M1RK02/SWDPProject/report/figures/Layer Stack.png

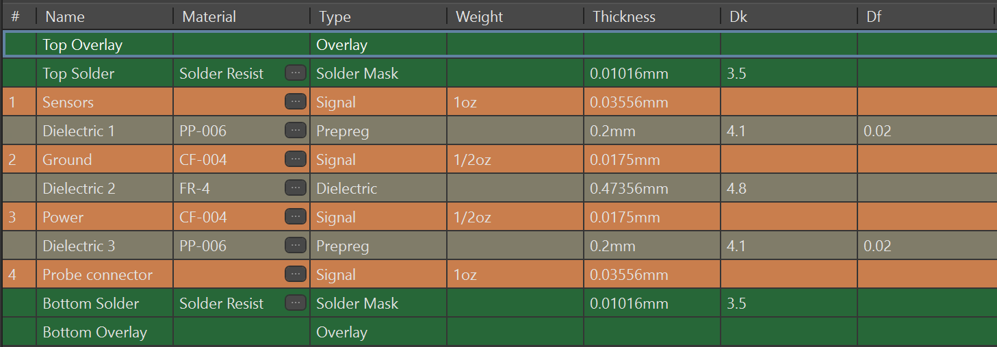
report/figures/Layer Stack.png
