M1RK02/SWDPProject/altium/Project Outputs for Lumos_Probe/BOM/Bill of Materials-Lumos_Probe.xlsx

Line # | Name | Description | Designator | Quantity | Manufacturer 1 | Manufacturer Part Number 1 | Manufacturer Lifecycle 1 | Supplier 1 | Supplier Part Number 1 | Supplier Unit Price 1 | Supplier Subtotal 1
 | 0402YC104JAT4A | Ceramic Capacitor, Multilayer, Ceramic, 16V, 5% +Tol, 5% -Tol, X7R, 15% TC, 0.1uF, Surface Mount, 0402 | C1, C3 | 2 | KYOCERA AVX | 0402YC104JAT4A | Volume Production | Avnet | KGM05AR71C104JN | 0.01101 | 550.5
 | 0402YD105KAT4A | Ceramic Capacitor, Multilayer, Ceramic, 16V, 10% +Tol, 10% -Tol, X5R, 15% TC, 1uF, Surface Mount, 0402 | C2 | 1 | KYOCERA AVX | 0402YD105KAT4A | Volume Production | Avnet | KGM05AR51C105KN | 0.0245 | 1225
 | BM29B0.6-24DS/2-0.35V(51) | Connector Receptacle 26 Pos (24+2) SMD | CONN1 | 1 | HIROSE ELECTRIC | BM29B0.6-24DS/2-0.35V(53) | Volume Production | DigiKey | 26-BM29B0.6-24DS/2-0.35V(53)CT-ND | 1.96 | 1.96
 | CR0201-JW-472GLF | Fixed Resistor, Metal Glaze/thick Film, 0.05W, 4700ohm, 30V, 5% +/-Tol, 200ppm/Cel, Surface Mount, 0201 | R1, R2, R3 | 3 | Bourns | CR0201-JW-472GLF | Volume Production | DigiKey | 118-CR0201-JW-472GLFCT-ND | 0.018 | 0.18
 | IMP34DT05 | MEMS audio sensor omnidirectional digital microphone for industrial applications | U2 | 1 |  |  |  | Farnell | 2980886
 | AS7341-DLGT | Optical Sensor Ambient - IÂ²C 8-TFLGA | U1 | 1 |  |  |  | Farnell | 4328201
