M1RK02/SWDPProject/report/figures/PCB matrix manufacturer .png

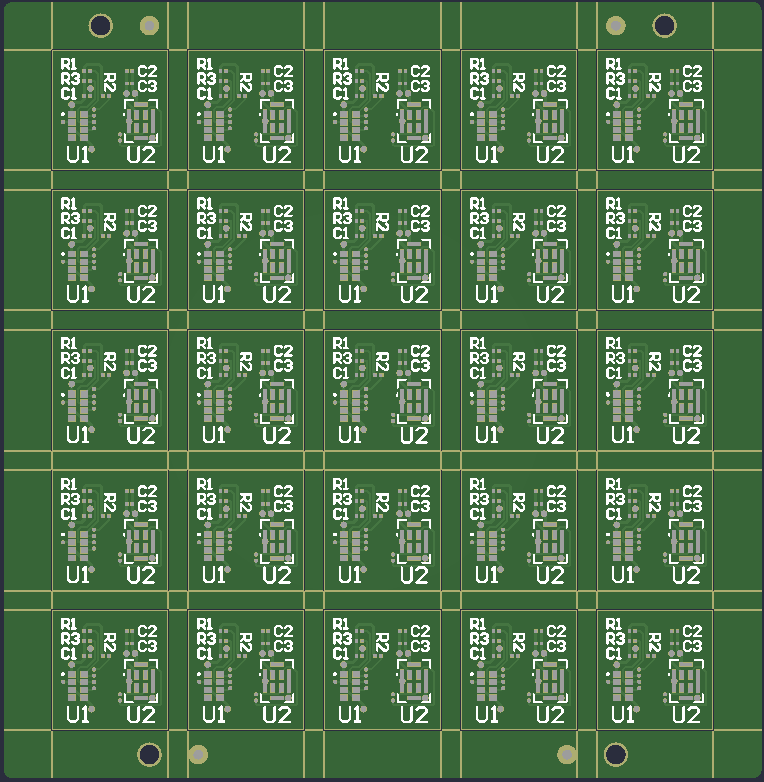
report/figures/PCB matrix manufacturer .png
