M1RK02/SWDPProject/(list of files, drawings)

Other design files:
altium/Lumos_Probe.PcbDoc
altium/Lumos_Probe.PcbLib
altium/Lumos_Probe.PrjPcb
altium/Lumos_Probe.SchDoc
altium/Lumos_Probe.SchLib
