M1RK02/SWDPProject/firmware/inference/Core/Src/main.c

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
/* Includes ------------------------------------------------------------------*/
#include "main.h"

/* USER CODE BEGIN Includes */
#include "string.h"
#include "stdio.h"
#include "../../USB_Device/App/usb_device.h"
#include "SPI.h"
#include "SPI_NAND.h"
#include "Memory_operations.h"
#include "led_driver.h"
#include "imu_driver.h"
#include "bluetooth.h"
#include "as7341.h"
#include "network.h"         // ST Edge-AI generated header
#include "network_data.h"    // Contains weights definitions
#include <math.h>
#include "features.h"
/* USER CODE END Includes */

/* USER CODE BEGIN PD */
// --- ⚙️ ARBITRARY INFERENCE STRIDE CONFIGURATION ---
#define INFERENCE_STRIDE_PACKETS   9  // 1 = Every 381ms, 3 = Every 1.1s, 9 = Non-overlapping
/* USER CODE END PD */


I2C_HandleTypeDef hi2c3;

MDF_HandleTypeDef MdfHandle0;
MDF_FilterConfigTypeDef MdfFilterConfig0;
DMA_NodeTypeDef Node_GPDMA1_Channel0;
DMA_QListTypeDef List_GPDMA1_Channel0;
DMA_HandleTypeDef handle_GPDMA1_Channel0;

SPI_HandleTypeDef hspi2;
SPI_HandleTypeDef hspi3;

UART_HandleTypeDef huart3;

PCD_HandleTypeDef hpcd_USB_OTG_FS;

/* USER CODE BEGIN PV */
// --- AI Framework Handles & Buffers (RESTORED TO FIX COMPILATION ERRORS) ---
static ai_handle network_instance = AI_HANDLE_NULL;

#define ACTIVATION_BUF_SIZE AI_NETWORK_DATA_ACTIVATIONS_SIZE
// 4-byte aligned internal activation buffer required for NN layer execution
static uint8_t activations_buffer[ACTIVATION_BUF_SIZE] __attribute__((aligned(4)));

static ai_buffer ai_input[AI_NETWORK_IN_NUM];
static ai_buffer ai_output[AI_NETWORK_OUT_NUM];

// --- Hardware Streaming Buffers ---
int16_t audio_circular_buffer[AUDIO_CIRC_BUF_SIZE]; // Double DMA Ping-Pong buffer

// --- Raw Sliding Window Storage Arrays ---
static int16_t audio_window_history[WINDOW_PACKET_COUNT][BLOCK_AUDIO_SAMPLES];
static uint16_t spectro_window_history[WINDOW_PACKET_COUNT][SPECTRAL_CHANNELS];
static AS7341_Flicker_t flicker_window_history[WINDOW_PACKET_COUNT]; // Aligned with updated struct type

static int write_ptr = 0;
static int blocks_accumulated = 0;
static int stride_counter = 0;

// Scratchpad buffer to piece together the continuous 3.43-second wave for processing
static int16_t audio_processing_scratchpad[TOTAL_WINDOW_SAMPLES];

// Output predictions buffer explicitly set to int8_t for the quantized output layer
static int8_t nn_output_predictions[AI_NETWORK_OUT_1_SIZE];
// Quantized input features array for X-CUBE-AI model (Size: 41)
static int8_t nn_input_features[AI_NETWORK_IN_1_SIZE];
// Temporary float array for feature extraction and normalization (Size: 41)
static float nn_input_features_float[AI_NETWORK_IN_1_SIZE];

static volatile uint8_t data_processing_requested = 0;
static volatile int processing_write_ptr = 0;

// Spectrometer data structures (Synchronized with data_logger)
AS7341_Handle_t h_as7341;
AS7341_SpectralData_t spectral_data;
AS7341_SpectralData_t spectral_data_buffer;
volatile bool spectral_data_ready = false;

// --- Global Flags and Variables ---
// Flag to indicate a USB connection event.
// Set to 1 when a USB connection is detected.
uint8_t usb_flag = 0;
/* USER CODE END PV */

void SystemClock_Config(void);
static void MX_GPIO_Init(void);
static void MX_GPDMA1_Init(void);
static void MX_ICACHE_Init(void);
static void MX_I2C3_Init(void);
static void MX_USART3_UART_Init(void);
static void MX_USB_OTG_FS_PCD_Init(void);
static void MX_MDF1_Init(void);
static void MX_SPI3_Init(void);
static void MX_SPI2_Init(void);
/* USER CODE BEGIN PFP */
/* USER CODE BEGIN 0 */
/**
  * @brief  Initializes X-CUBE-AI Network instances
  */
void AI_Init(void)
{
    ai_error err;
    ai_handle activations_list[] = { (ai_handle)activations_buffer };

    err = ai_network_create_and_init(&network_instance, activations_list, NULL);
    if (err.type != AI_ERROR_NONE) {
        Error_Handler();
    }

    ai_input[0]  = *ai_network_inputs_get(network_instance, NULL);
    ai_output[0] = *ai_network_outputs_get(network_instance, NULL);

    // Map feature references: float32 for input features, int8_t for output predictions
    ai_input[0].data  = (ai_handle)nn_input_features;
    ai_output[0].data = (ai_handle)nn_output_predictions;
}

/**
  * @brief  Runs inference pipeline inside X-CUBE-AI Runtime context
  */
void Run_Inference(void)
{
    ai_i32 n_batch;
    n_batch = ai_network_run(network_instance, &ai_input[0], &ai_output[0]);
    if (n_batch != 1) {
        Error_Handler();
    }
}
/* USER CODE END 0 */

/**
  * @brief  The application entry point.
  * @retval int
  */
int main(void)
{

  /* MCU Configuration--------------------------------------------------------*/

  /* Reset of all peripherals, Initializes the Flash interface and the Systick. */
  HAL_Init();

  /* Configure the system clock */
  SystemClock_Config();

  /* Initialize all configured peripherals */
  MX_GPIO_Init();
  MX_GPDMA1_Init();
  MX_ICACHE_Init();
  MX_I2C3_Init();
  MX_USART3_UART_Init();
  MX_USB_OTG_FS_PCD_Init();
  MX_MDF1_Init();
  MX_SPI3_Init();
  MX_SPI2_Init();
  /* USER CODE BEGIN 2 */
  BLE_Initialize();
  MX_USB_Device_Init();
  HAL_Delay(1000);

  // Initialize X-CUBE-AI model platform
  AI_Init();

  

  // Inizializzazione Spettrometro AS7341 (Updated layout matching main_datalogger.c)
  if (AS7341_Init(&h_as7341, &hi2c3, 99, 599, AS7341_GAIN_8X, true) != AS7341_OK) {
      LED_On(LED_RED);
      Error_Handler();
  }

  // Kick off initial asynchronous spectrometer read sequence launch
  AS7341_StartRead(&h_as7341);

  // --- START CONTINUOUS CIRCULAR DMA AUDIO STREAM ---
  MDF_DmaConfigTypeDef mdf_dma_config = {0};
  mdf_dma_config.Address = (uint32_t)audio_circular_buffer;
  mdf_dma_config.DataLength  = AUDIO_CIRC_BUF_SIZE * sizeof(int16_t);
  mdf_dma_config.MsbOnly = ENABLE;

  if (HAL_MDF_AcqStart_DMA(&MdfHandle0, &MdfFilterConfig0, &mdf_dma_config) != HAL_OK) {
      LED_On(LED_RED);
      Error_Handler();
  }
  /* USER CODE END 2 */

  /* Infinite loop */
  /* USER CODE BEGIN WHILE */
  while (1)
  {
    /* USER CODE END WHILE */

    /* USER CODE BEGIN 3 */
    if (data_processing_requested)
    {
        data_processing_requested = 0;

        // --- Reconstruct Continuous Chronological Audio Vector ---
        int current_slot = processing_write_ptr; // The oldest slot is exactly where write_ptr currently sits
        for (int i = 0; i < WINDOW_PACKET_COUNT; i++) {
            memcpy(&audio_processing_scratchpad[i * BLOCK_AUDIO_SAMPLES], 
                   audio_window_history[current_slot], 
                   BLOCK_AUDIO_SAMPLES * sizeof(int16_t));
            current_slot = (current_slot + 1) % WINDOW_PACKET_COUNT;
        }

        // --- Feature Extraction from sliding windows ---
        // Fills indices 0 to 16
        Extract_Spectro_Features_Window(spectro_window_history, nn_input_features_float);
        
        // Fills indices 17 to 22 
        Extract_Flicker_Features_Window(flicker_window_history, WINDOW_PACKET_COUNT, nn_input_features_float);
        
        // Fills indices 23 to 40
        Extract_Audio_Features_Window(audio_processing_scratchpad, TOTAL_WINDOW_SAMPLES, nn_input_features_float);
        
        // Normalize the final combined vector
        Apply_Normalization(nn_input_features_float);
        
        // Quantize the float features to int8 for the quantized model input
        // Using scale 0.0541030541062355f and zero-point -71
        for (int i = 0; i < AI_NETWORK_IN_1_SIZE; i++) {
            float q_val = roundf(nn_input_features_float[i] / 0.0541030541062355f) - 71.0f;
            if (q_val < -128.0f) q_val = -128.0f;
            if (q_val > 127.0f) q_val = 127.0f;
            nn_input_features[i] = (int8_t)q_val;
        }

        // Runs your full 1-shot model execution
        Run_Inference();

        // Find the maximum probability across all 5 classes
        int8_t max_probability = -128; // Smallest possible int8 value
        uint8_t winning_class_idx = 0;

        for (uint8_t i = 0; i < 5; i++) {
            if (nn_output_predictions[i] > max_probability) {
                max_probability = nn_output_predictions[i];
                winning_class_idx = i;
            }
        }

        //SEND PACKET THERE
        int latest_idx = (processing_write_ptr - 1 + WINDOW_PACKET_COUNT) % WINDOW_PACKET_COUNT;
        BLE_SendLumosPacket((uint8_t)winning_class_idx, spectro_window_history[latest_idx]);

        // Act on the winning index based on hardware LEDs as before:
        switch (winning_class_idx) {
            case 0: // UNDERGROUND
                LED_Off(LED_RED);
                LED_Off(LED_GREEN);
                break;
            case 1: // OUTDOOR
                LED_Off(LED_RED);
                LED_On(LED_GREEN);
                break;
            case 2: // INDOOR_QUIET
                LED_On(LED_RED);
                LED_Off(LED_GREEN);
                break;
            case 3: // INDOOR_NORMAL
                LED_On(LED_RED);
                LED_On(LED_GREEN);
                break;
            default: // COVERED_DARK
                LED_Off(LED_RED);
                LED_On(LED_GREEN);
                break;
        }
    }

    // Critical Section: Sleep entry
    __disable_irq();
    if (!data_processing_requested)
    {
        HAL_PWR_EnterSLEEPMode(PWR_MAINREGULATOR_ON, PWR_SLEEPENTRY_WFI);
    }
    __enable_irq();
  }
  /* USER CODE END 3 */
}

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
/* USER CODE BEGIN 4 */
/**
  * @brief  Spectrometer Hardware Data Read Interrupt Callback
  */
void HAL_GPIO_EXTI_Falling_Callback(uint16_t GPIO_Pin) {
    if (GPIO_Pin == MCU_I_O_1_Pin) {
        HAL_NVIC_DisableIRQ(MCU_I_O_1_EXTI_IRQn);

        if (AS7341_IRQHandler(&h_as7341, &spectral_data)) {
            // Evaluates true only when Cycle 2 concludes cleanly
            spectral_data_buffer = spectral_data; 
            spectral_data_ready = true;
            
            // FIX: Kick off the next asynchronous integration sweep immediately
            AS7341_StartRead(&h_as7341);
        }

        __HAL_GPIO_EXTI_CLEAR_IT(MCU_I_O_1_Pin);
        HAL_NVIC_EnableIRQ(MCU_I_O_1_EXTI_IRQn);
    }
}

/**
  * @brief  Core ingestion routine for 381.4ms chunks.
  * Reconstructs continuous streams and handles arbitrary sliding strides.
  */
void Ingest_Block_To_Sliding_Window(int16_t* raw_audio_source) {
    // 1. Direct memory save into active rolling storage slot
    memcpy(audio_window_history[write_ptr], raw_audio_source, BLOCK_AUDIO_SAMPLES * sizeof(int16_t));
    
    // Assign spectrometer channels (fallback to last if spectral_data_ready was false)
    spectro_window_history[write_ptr][0] = spectral_data_buffer.f1;
    spectro_window_history[write_ptr][1] = spectral_data_buffer.f2;
    spectro_window_history[write_ptr][2] = spectral_data_buffer.f3;
    spectro_window_history[write_ptr][3] = spectral_data_buffer.f4;
    spectro_window_history[write_ptr][4] = spectral_data_buffer.f5;
    spectro_window_history[write_ptr][5] = spectral_data_buffer.f6;
    spectro_window_history[write_ptr][6] = spectral_data_buffer.f7;
    spectro_window_history[write_ptr][7] = spectral_data_buffer.f8;
    spectro_window_history[write_ptr][8] = spectral_data_buffer.clear;
    spectro_window_history[write_ptr][9] = spectral_data_buffer.nir;
    
    // Aligned tracking using the background calculation engine result flag member
    flicker_window_history[write_ptr] = spectral_data_buffer.flicker;
    
    // Consume spectrometer flag until hardware updates it again
    spectral_data_ready = false;

    // Advance circular ring write pointer indices
    write_ptr = (write_ptr + 1) % WINDOW_PACKET_COUNT;
    if (blocks_accumulated < WINDOW_PACKET_COUNT) {
        blocks_accumulated++;
    }
    
    stride_counter++;

    // 2. Process window if buffer is fully primed and stride parameter is met
    if (blocks_accumulated == WINDOW_PACKET_COUNT && stride_counter >= INFERENCE_STRIDE_PACKETS) {
        stride_counter = 0; // Reset stride steps accumulator
        processing_write_ptr = write_ptr;
        data_processing_requested = 1;
    }
}

/**
  * @brief  MDF Circular Buffer Half Transfer Callback (PING ready)
  */
void HAL_MDF_AcqHalfCpltCallback(MDF_HandleTypeDef *hmdf) {
    if (hmdf->Instance == MDF1_Filter0) {
        // First 6102 samples of the circular array are ready
        Ingest_Block_To_Sliding_Window(&audio_circular_buffer[0]);
    }
}

/**
  * @brief  MDF Circular Buffer Full Transfer Complete Callback (PONG ready)
  */
void HAL_MDF_AcqCpltCallback(MDF_HandleTypeDef *hmdf) {
    if (hmdf->Instance == MDF1_Filter0) {
        // Second 6102 samples of the circular array are ready
        Ingest_Block_To_Sliding_Window(&audio_circular_buffer[BLOCK_AUDIO_SAMPLES]);
    }
}
/* USER CODE END 4 */
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
