M1RK02/SWDPProject/firmware/data_logger/data_logger.ioc

Mcu.UserName=STM32U575RITxQ
PA0.GPIO_Label=IMU_IS_INT2
PA0.Signal=GPXTI0
PA11.Signal=USB_OTG_FS_DM
PA12.Signal=USB_OTG_FS_DP
PA2.Signal=GPIO_Output
PA4.GPIO_Label=SPI3_CS_NAND
PA4.Signal=GPIO_Output
PA5.Signal=USART3_RX
PA7.Signal=USART3_TX
PA9.Signal=USB_OTG_FS_VBUS
PB1.Signal=MDF1_SDI0
PB10.GPIO_Label=USER_BUTTON
PB10.Signal=GPXTI10
PB13.Signal=SPI2_SCK
PB15.Signal=SPI2_MOSI
PB5.GPIO_Label=MCU_I/O_1
PB5.Signal=GPXTI5
PB6.GPIO_Label=MCU_GREEN_LED
PB6.Signal=GPIO_Output
PB7.GPIO_Label=MCU_RED_LED
PB7.Signal=GPIO_Output
PB8.Signal=MDF1_CCK0
PC0.Signal=I2C3_SCL
PC1.Signal=I2C3_SDA
PC10.Signal=SPI3_SCK
PC11.Signal=SPI3_MISO
PC12.Signal=SPI3_MOSI
PC13.GPIO_Label=IMU_IS_INT1
PC13.Signal=GPXTI13
PC2.Signal=SPI2_MISO
PC3.Signal=GPIO_Output
PC6.GPIO_Label=BLE_P0_0
PC6.Signal=GPIO_Output
PC7.GPIO_Label=BLE_P3_6
PC7.Signal=GPIO_Output
PC8.GPIO_Label=BLE_UART_RX_IND
PC8.Signal=GPIO_Output
PC9.GPIO_Label=BLE_RESET
PC9.Signal=GPIO_Output
