M1RK02/SWDPProject/firmware/inference/Core/Inc/main.h

#define IMU_IS_INT1_Pin GPIO_PIN_13
#define IMU_IS_INT1_GPIO_Port GPIOC
#define IMU_IS_INT1_EXTI_IRQn EXTI13_IRQn
#define IMU_IS_INT2_Pin GPIO_PIN_0
#define IMU_IS_INT2_GPIO_Port GPIOA
#define IMU_IS_INT2_EXTI_IRQn EXTI0_IRQn
#define SPI3_CS_NAND_Pin GPIO_PIN_4
#define SPI3_CS_NAND_GPIO_Port GPIOA
#define USER_BUTTON_Pin GPIO_PIN_10
#define USER_BUTTON_GPIO_Port GPIOB
#define USER_BUTTON_EXTI_IRQn EXTI10_IRQn
#define BLE_P0_0_Pin GPIO_PIN_6
#define BLE_P0_0_GPIO_Port GPIOC
#define BLE_P3_6_Pin GPIO_PIN_7
#define BLE_P3_6_GPIO_Port GPIOC
#define BLE_UART_RX_IND_Pin GPIO_PIN_8
#define BLE_UART_RX_IND_GPIO_Port GPIOC
#define BLE_RESET_Pin GPIO_PIN_9
#define BLE_RESET_GPIO_Port GPIOC
#define BLE_CONFIG_Pin GPIO_PIN_15
#define BLE_CONFIG_GPIO_Port GPIOA
#define MCU_I_O_2_Pin GPIO_PIN_4
#define MCU_I_O_2_GPIO_Port GPIOB
#define MCU_I_O_2_EXTI_IRQn EXTI4_IRQn
#define MCU_I_O_1_Pin GPIO_PIN_5
#define MCU_I_O_1_GPIO_Port GPIOB
#define MCU_I_O_1_EXTI_IRQn EXTI5_IRQn
#define MCU_GREEN_LED_Pin GPIO_PIN_6
#define MCU_GREEN_LED_GPIO_Port GPIOB
#define MCU_RED_LED_Pin GPIO_PIN_7
#define MCU_RED_LED_GPIO_Port GPIOB
#define I2C_TIMEOUT 100
