M1RK02/SWDPProject/(commit log)

2026-05-22 Started from professor IMU logger
2026-05-22 Configured MDF and DMA for the microphone
2026-05-22 Added spectrometer driver
2026-05-25 First recorded data
    [Acquario_20260525_125824_spectral.csv, Outside_20260525_114451_spectral.csv]
2026-06-16 Quick fixes to range and data structure
    [Memory_operations.c, Memory_operations.h, download_data.py, main.c]
2026-06-17 Changed spectrometer to read with interrupt callback
2026-06-17 Modified python to account for new packet structure
    [Acquario_20260525_125824_spectral.csv, Outside_20260525_114451_spectral.csv, StudyRoom_spectral.csv]
2026-06-17 Added model using STM32CUBEMX
2026-06-18 New data - Model training need to do feature extraction on audio - Inference firmware needs to be changed
    [OutsideSunShade_spectral.csv, Underground_spectral.csv]
2026-06-18 New npz structure - We did the packet merging as discussed - We added labels in the npz
    [OutsideSunWalking_spectral.csv]
2026-06-18 New data
    [InsideBag_spectral.csv, RoomTalking_spectral.csv]
2026-06-18 Added python model
    [confusion_matrix.csv, tinyml_features.csv]
2026-06-19 Cleaned up model notebook and fixed code
    [confusion_matrix.csv, tinyml_features.csv]
2026-06-19 Added a few recording for more generalization
    [Building2Studying_spectral.csv, Building2_spectral.csv, tinyml_features.csv]
2026-06-19 Solved some bugs in the app, implemented correct logic for BLE packets
    [as7341.h, bluetooth.c, bluetooth.h, main.c]
2026-06-19 Added data and retrained model
    [EmptyRoomFans_spectral.csv, MusicTalking_spectral.csv, WalkingCorridor_spectral.csv, tinyml_features.csv]
2026-06-19 New data and retrain
    [Drawer_spectral.csv, Home_spectral.csv, PiolaUdine_spectral.csv, tinyml_features.csv]
2026-06-20 Improved and retrained model
    [tinyml_features.csv]
2026-06-20 Fixed memory race condition
    [bluetooth.c, bluetooth.h, main.c]
2026-06-20 Added altium PCB design
    [Bill of Materials-Lumos_Probe.xlsx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]
2026-06-20 Removed wav and csv
    [Building2Studying_spectral.csv, Building2_spectral.csv, Drawer_spectral.csv, EmptyRoomFans_spectral.csv, Home_spectral.csv, InsideBag_spectral.csv, Library_spectral.csv, MusicTalking_spectral.csv]
2026-06-21 Added basic low power logic
